BartekChelminski/Wireless-guitar-system-aka-kabel-bezprzewodowy/(commit log)

2025-12-22 Latency measurement for esp32
2026-01-10 Sending 2 channel 800hz audio via i2s to codec, then output
2026-01-12 Program generujacy sin 800hz na esp 32 s3
2026-01-13 debug wireless connection
2026-01-15 Wireless_audio_transmittion_Firs _Success
2026-03-01 Changed catalog structure, added current version of documentation, updated README
2026-03-16 first version of ADC configuration
2026-03-24 ADC config update
2026-05-24 Accomplished full trasmission at 2.5 ms frames
